simone-piccinini/Hybrid-Reaction-Wheel-Pendulum/docs/architecture/class_diagram.png

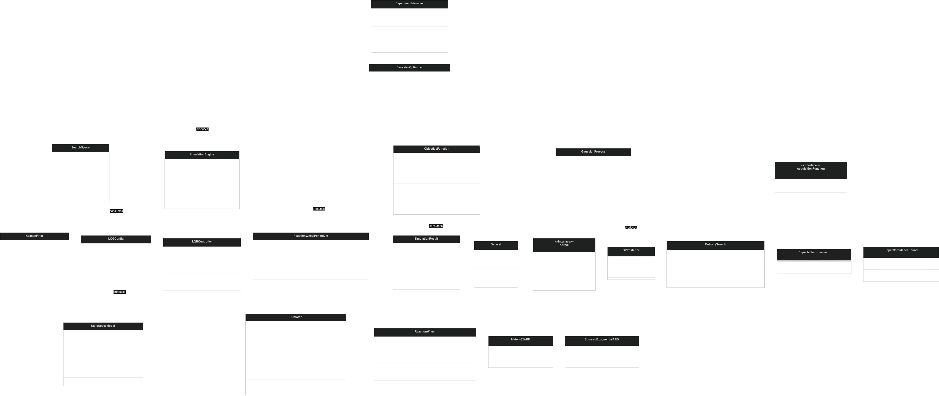
docs/architecture/class_diagram.png
