simone-piccinini/Hybrid-Reaction-Wheel-Pendulum/build/first_build/all2.jpeg

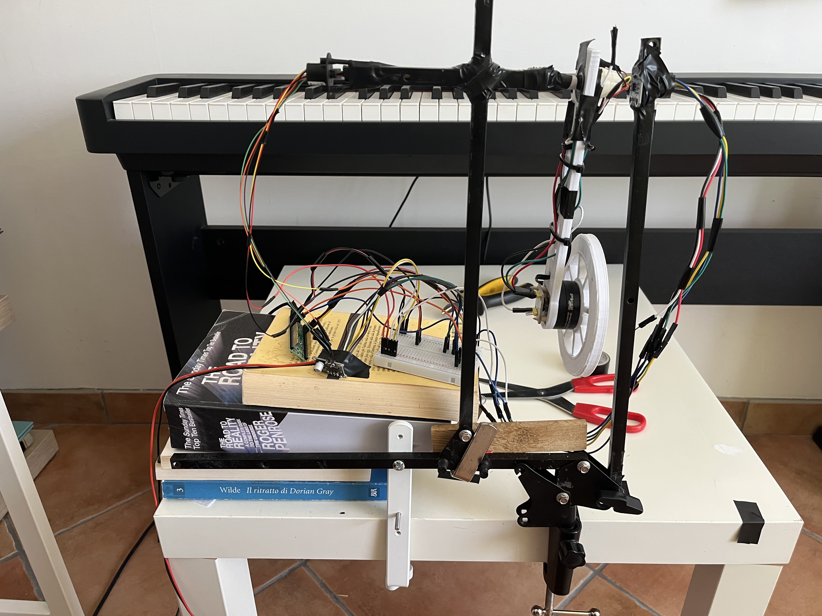
build/first_build/all2.jpeg
