simone-piccinini/Hybrid-Reaction-Wheel-Pendulum/build/first_build/connections.jpeg

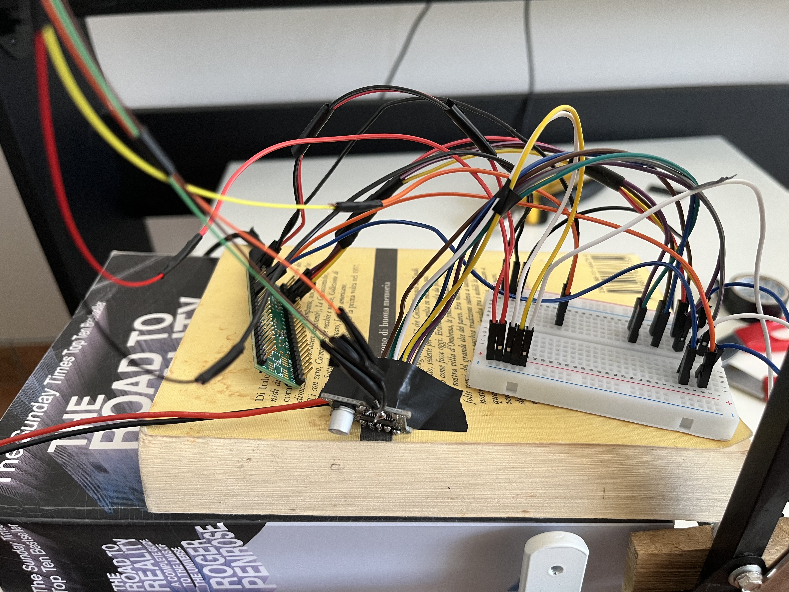
build/first_build/connections.jpeg
