simone-piccinini/Hybrid-Reaction-Wheel-Pendulum/build/first_build/sail_ring.jpeg

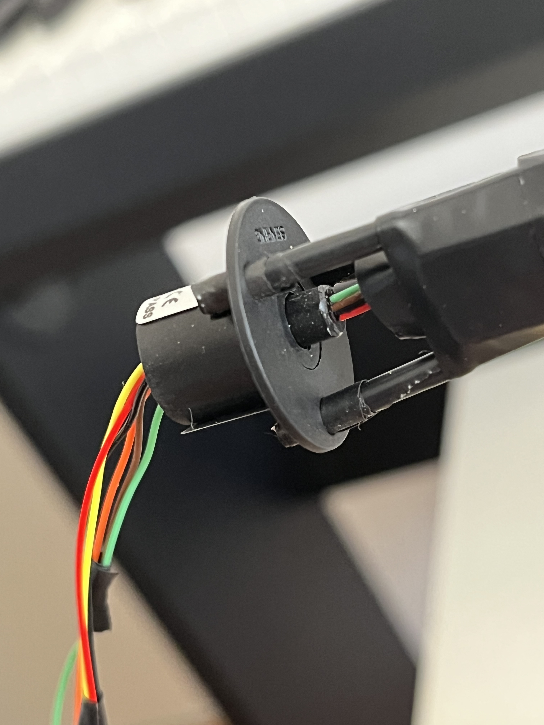
build/first_build/sail_ring.jpeg
