simone-piccinini/Hybrid-Reaction-Wheel-Pendulum/results/build_v2/convergence.png

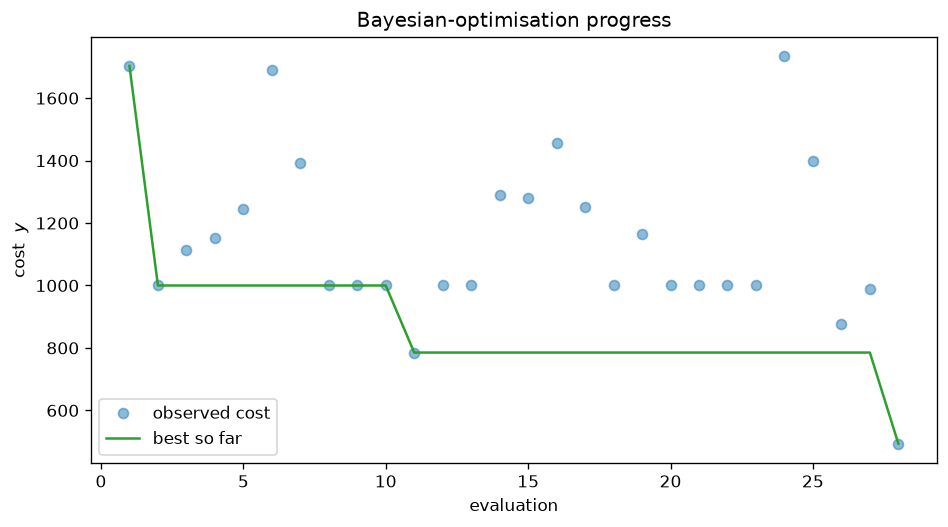
results/build_v2/convergence.png
