simone-piccinini/Hybrid-Reaction-Wheel-Pendulum/results/build_v2/trajectory.png

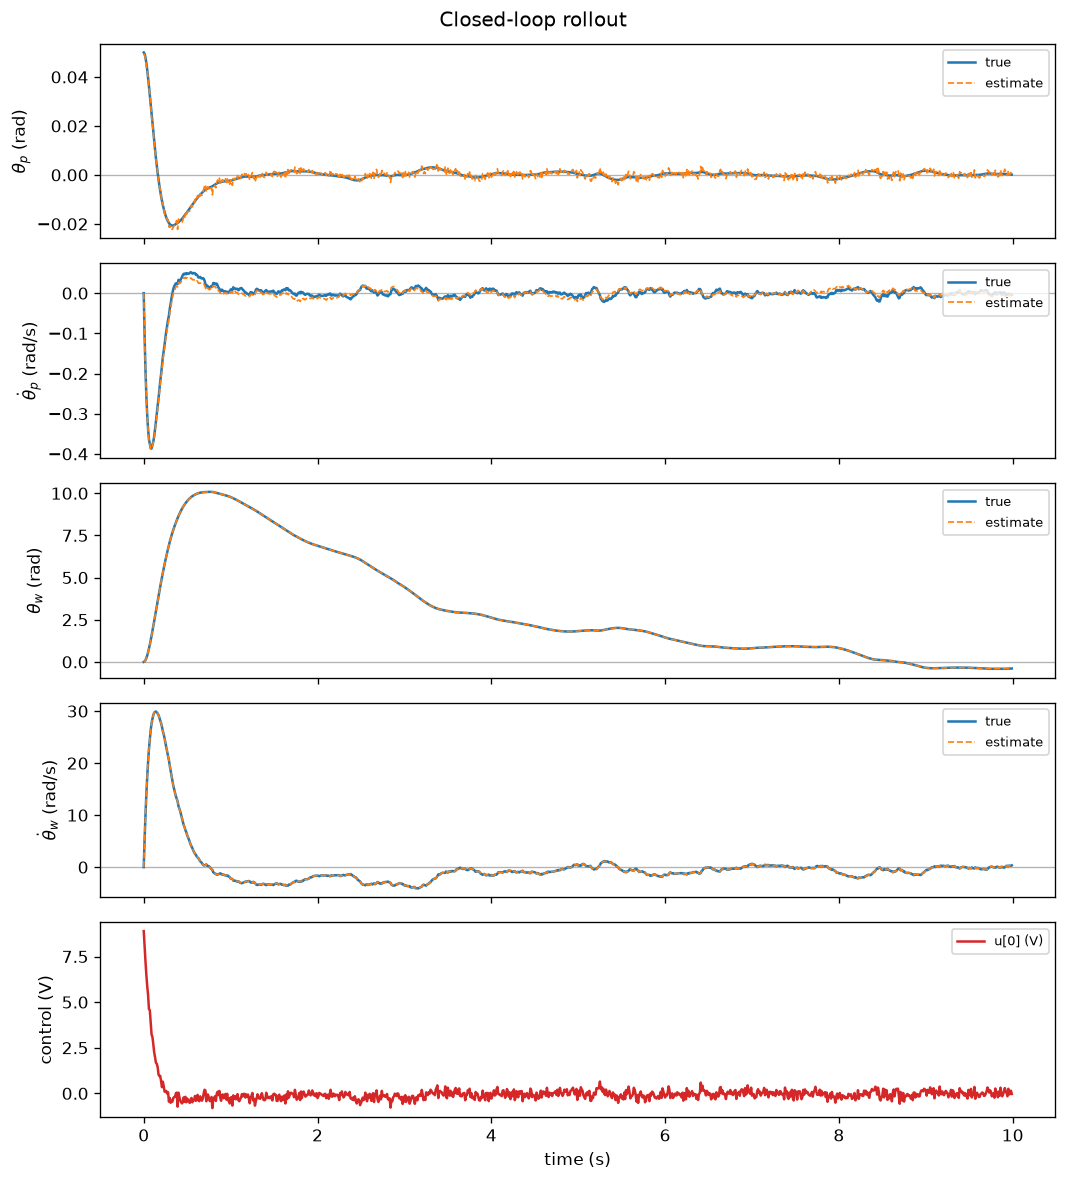
results/build_v2/trajectory.png
