simone-piccinini/Hybrid-Reaction-Wheel-Pendulum/results/build_v2_fw/convergence.png

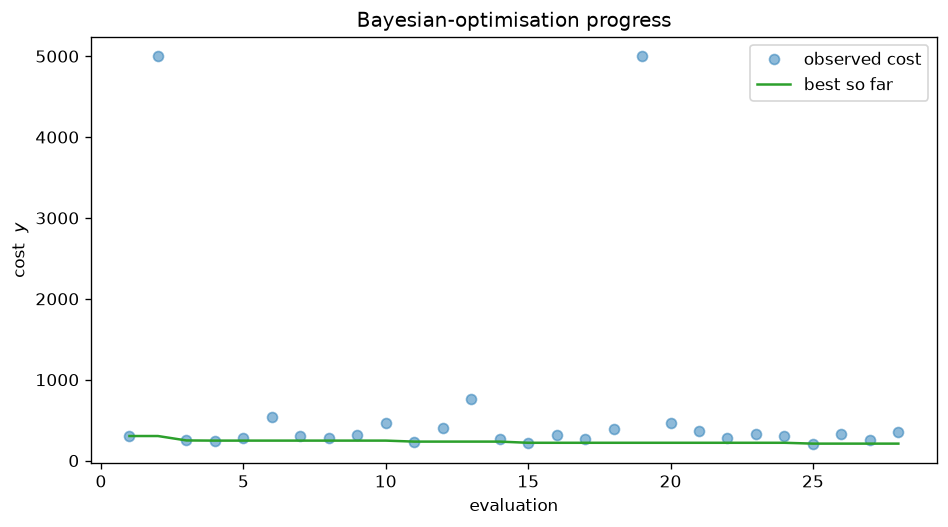
results/build_v2_fw/convergence.png
