simone-piccinini/Hybrid-Reaction-Wheel-Pendulum/results/build_v2_fw/trajectory.png

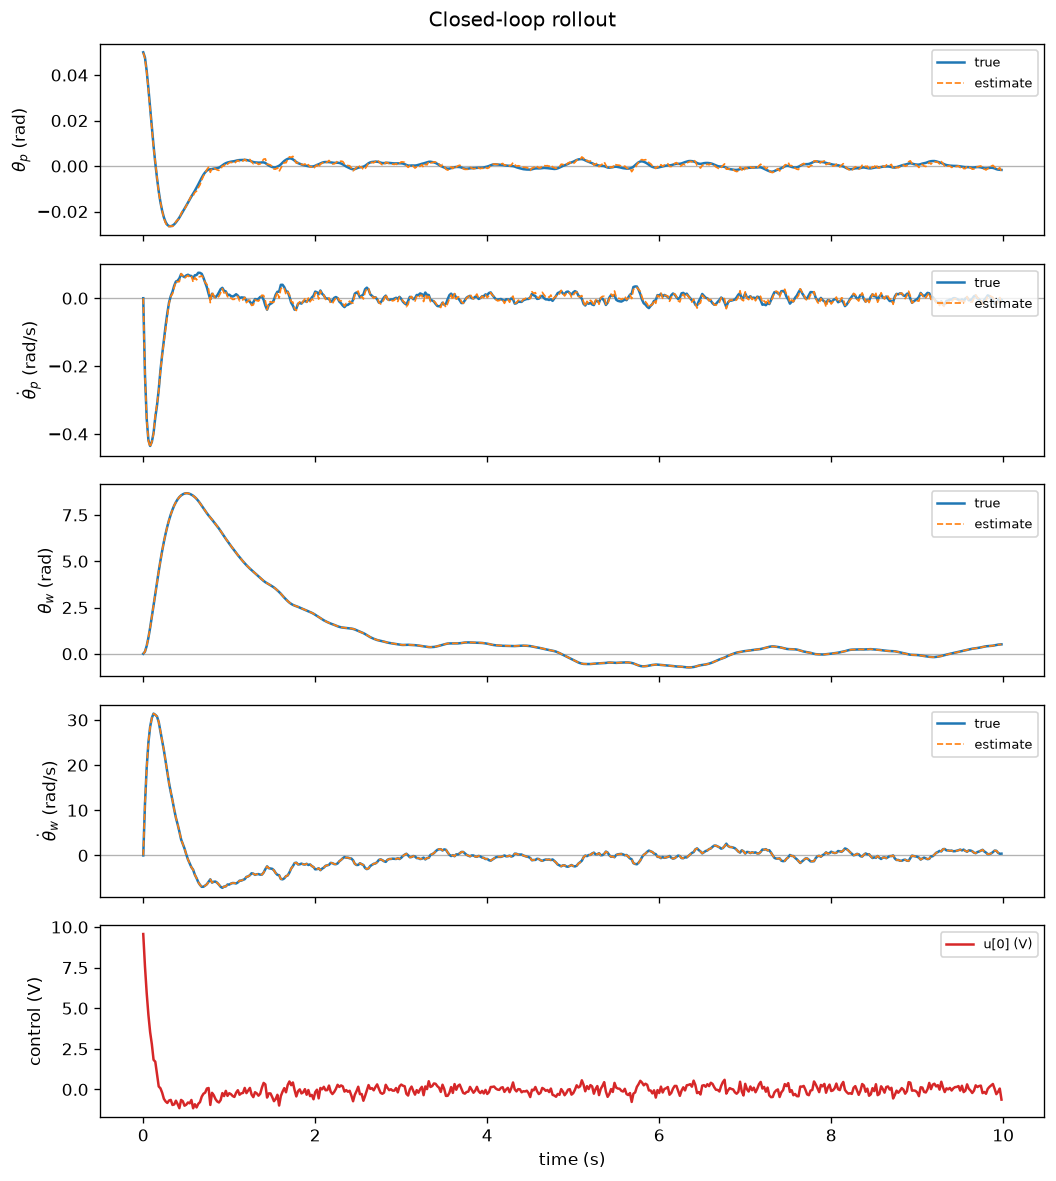
results/build_v2_fw/trajectory.png
