simone-piccinini/Hybrid-Reaction-Wheel-Pendulum/results/build_v2_measured/convergence.png

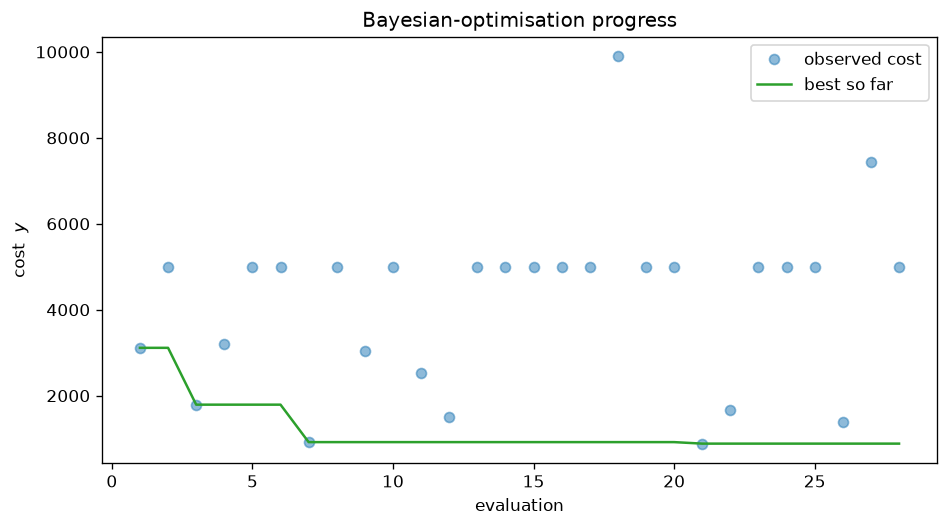
results/build_v2_measured/convergence.png
