simone-piccinini/Hybrid-Reaction-Wheel-Pendulum/results/build_v2_measured/trajectory.png

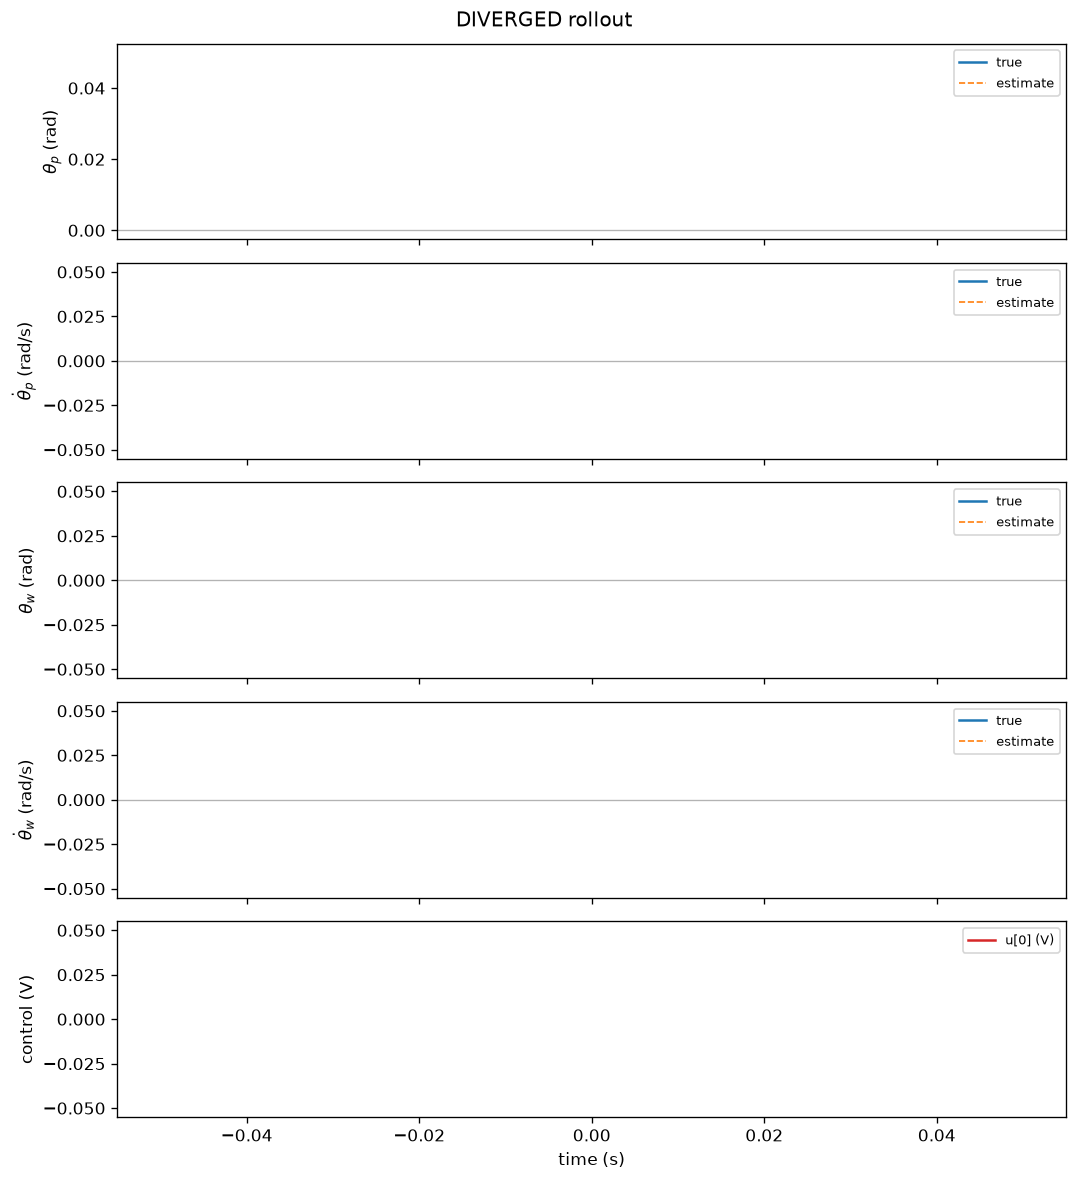
results/build_v2_measured/trajectory.png
