simone-piccinini/Hybrid-Reaction-Wheel-Pendulum/results/AT1/convergence.png

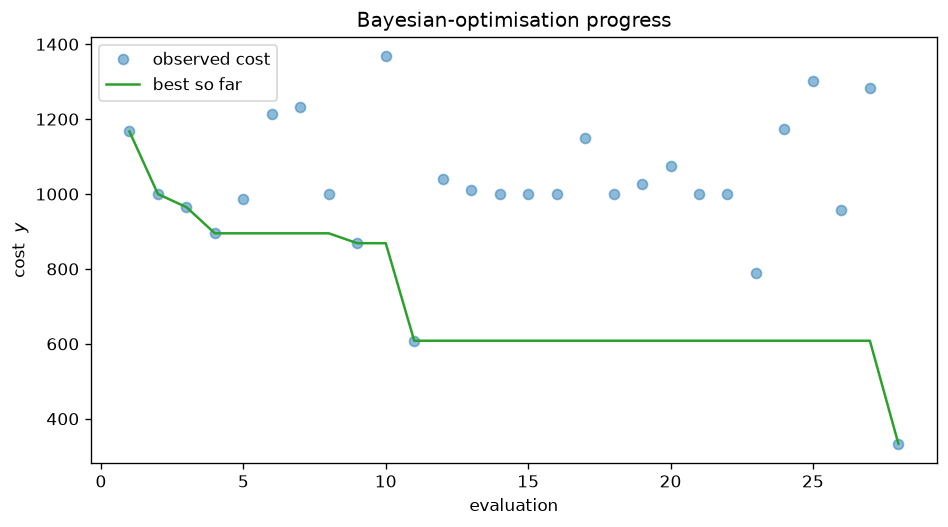
results/AT1/convergence.png
