simone-piccinini/Hybrid-Reaction-Wheel-Pendulum/results/AT1/trajectory.png

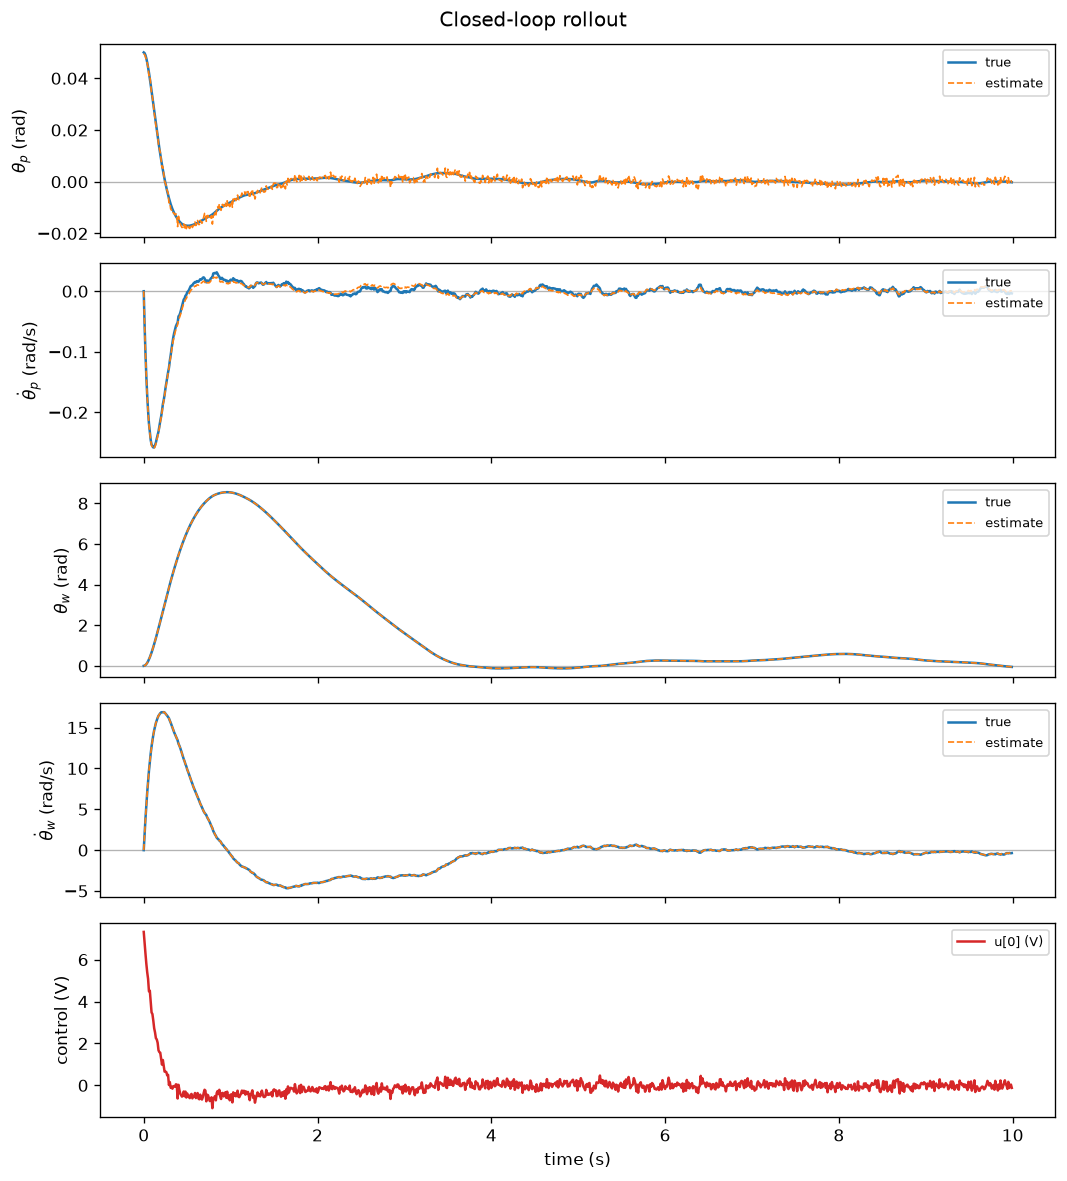
results/AT1/trajectory.png
