simone-piccinini/Hybrid-Reaction-Wheel-Pendulum/results/identified/convergence.png

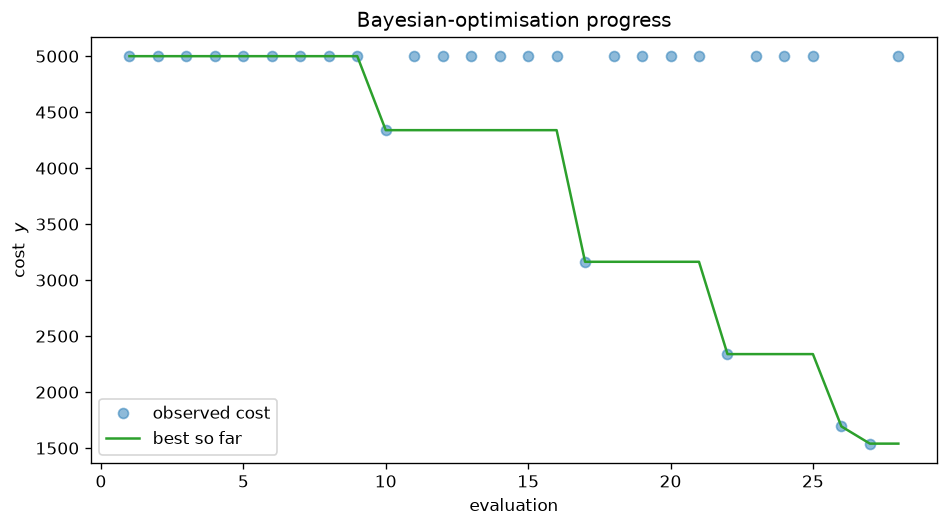
results/identified/convergence.png
