simone-piccinini/Hybrid-Reaction-Wheel-Pendulum/results/identified/trajectory.png

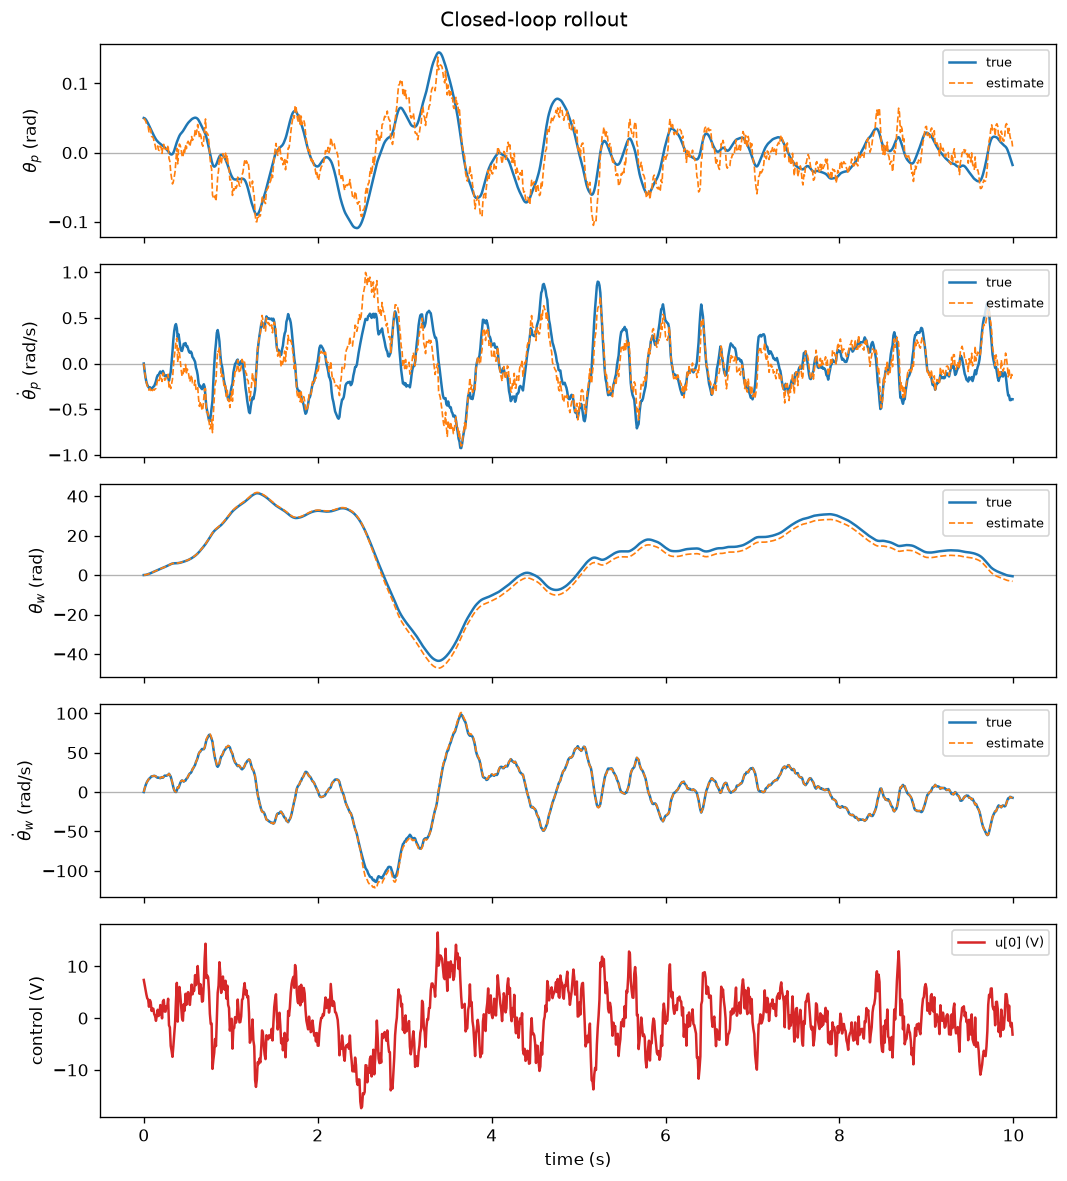
results/identified/trajectory.png
