simone-piccinini/Hybrid-Reaction-Wheel-Pendulum/results/identified_swingup/swing_up.png

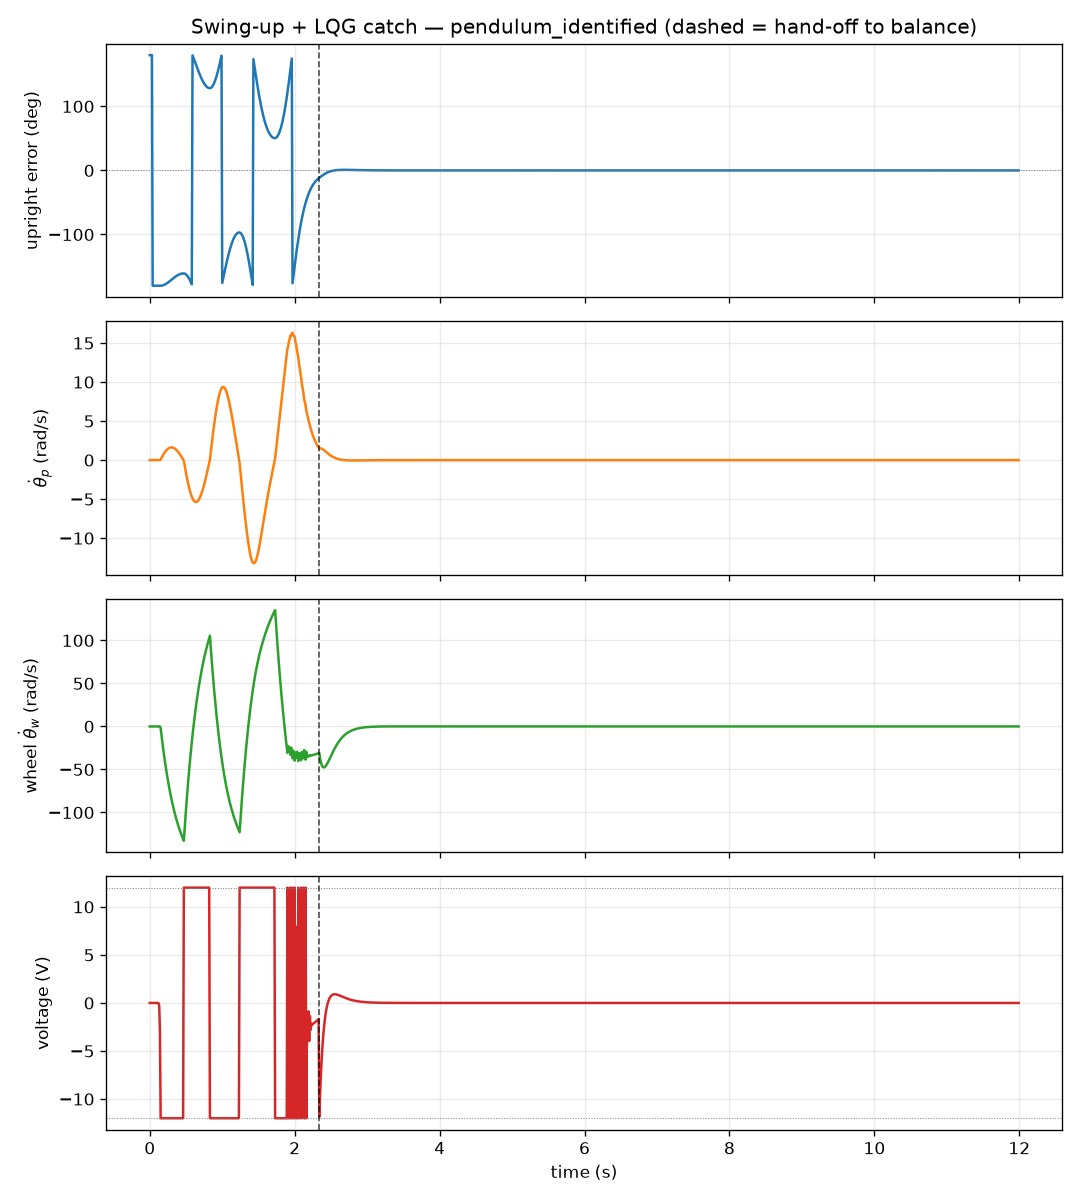
results/identified_swingup/swing_up.png
