simone-piccinini/Hybrid-Reaction-Wheel-Pendulum/results/margins/loop_bode.png

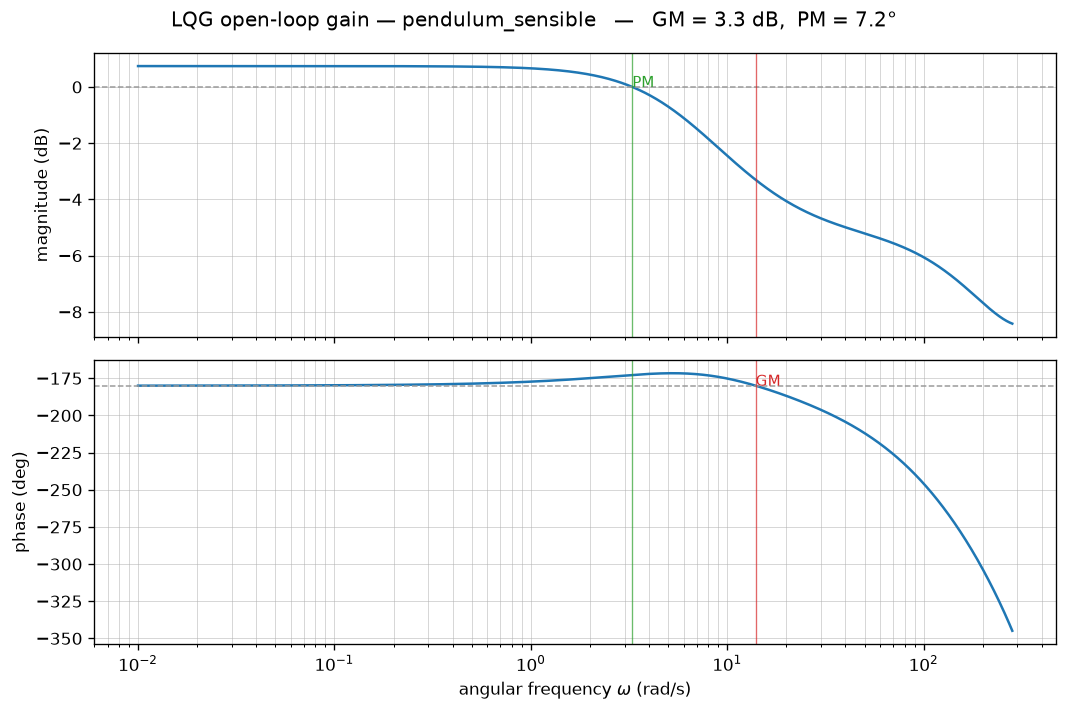
results/margins/loop_bode.png
