simone-piccinini/Hybrid-Reaction-Wheel-Pendulum/results/run01/convergence.png

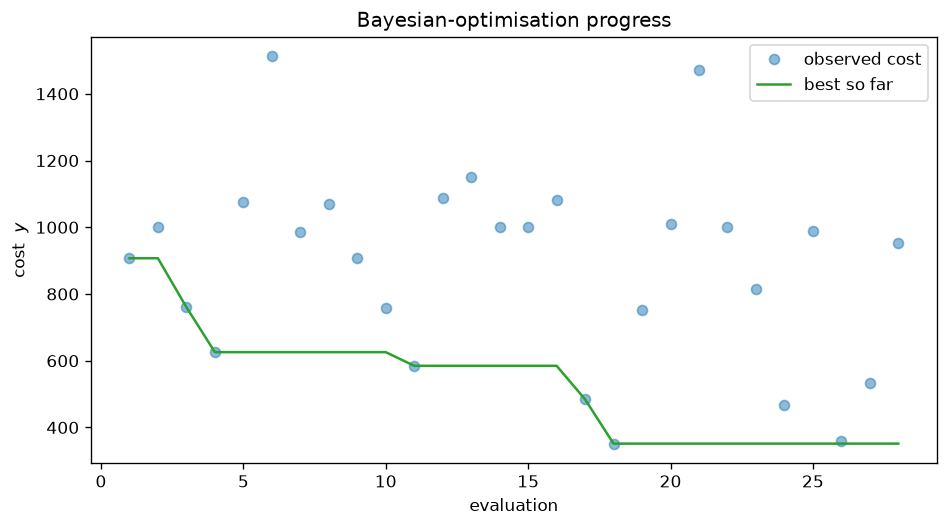
results/run01/convergence.png
