simone-piccinini/Hybrid-Reaction-Wheel-Pendulum/results/run01/trajectory.png

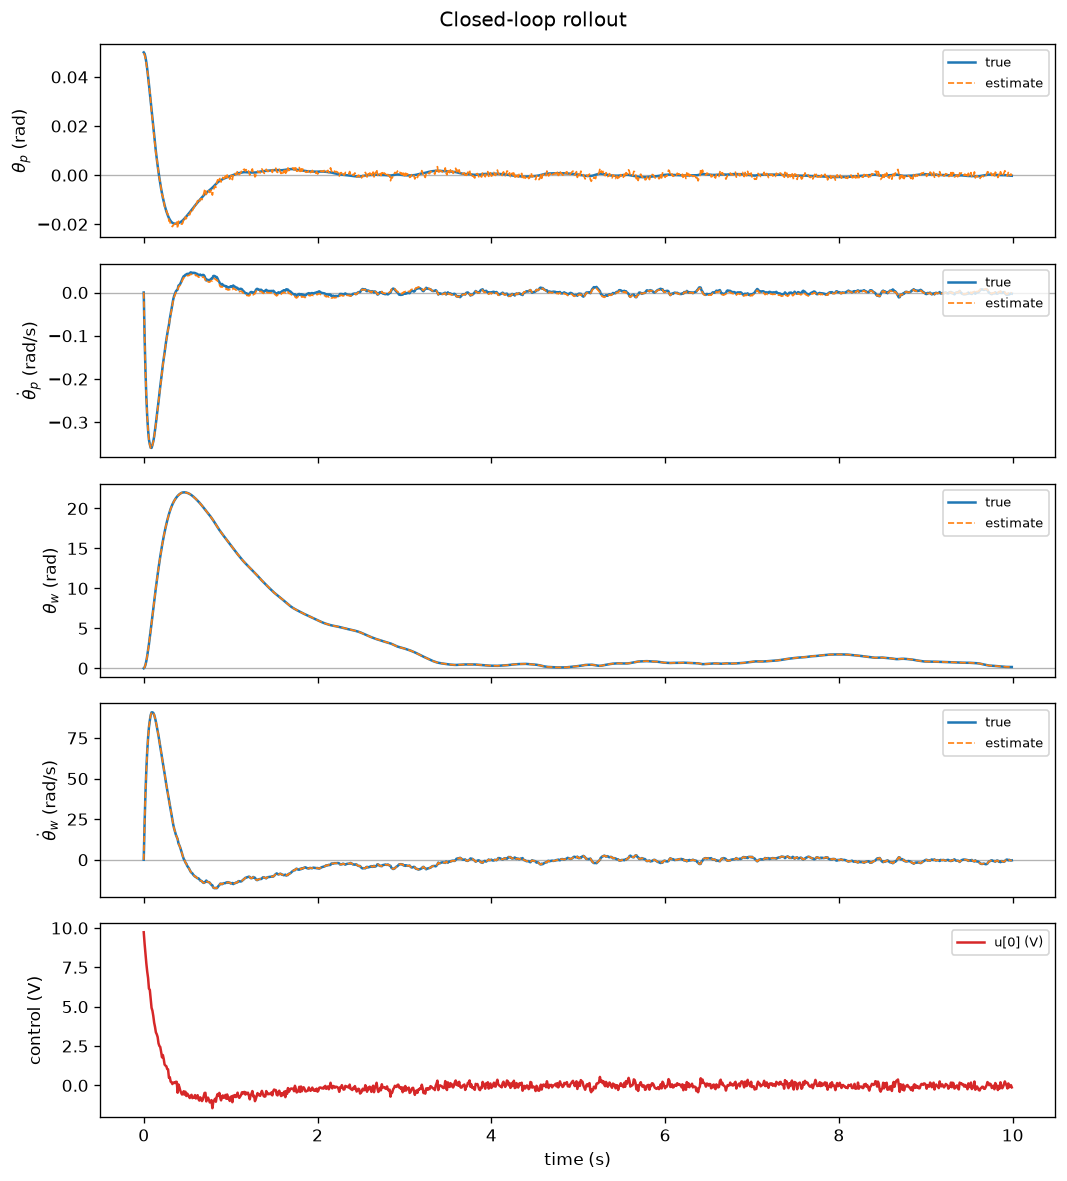
results/run01/trajectory.png
