simone-piccinini/Hybrid-Reaction-Wheel-Pendulum/results/swingup/swing_up.png

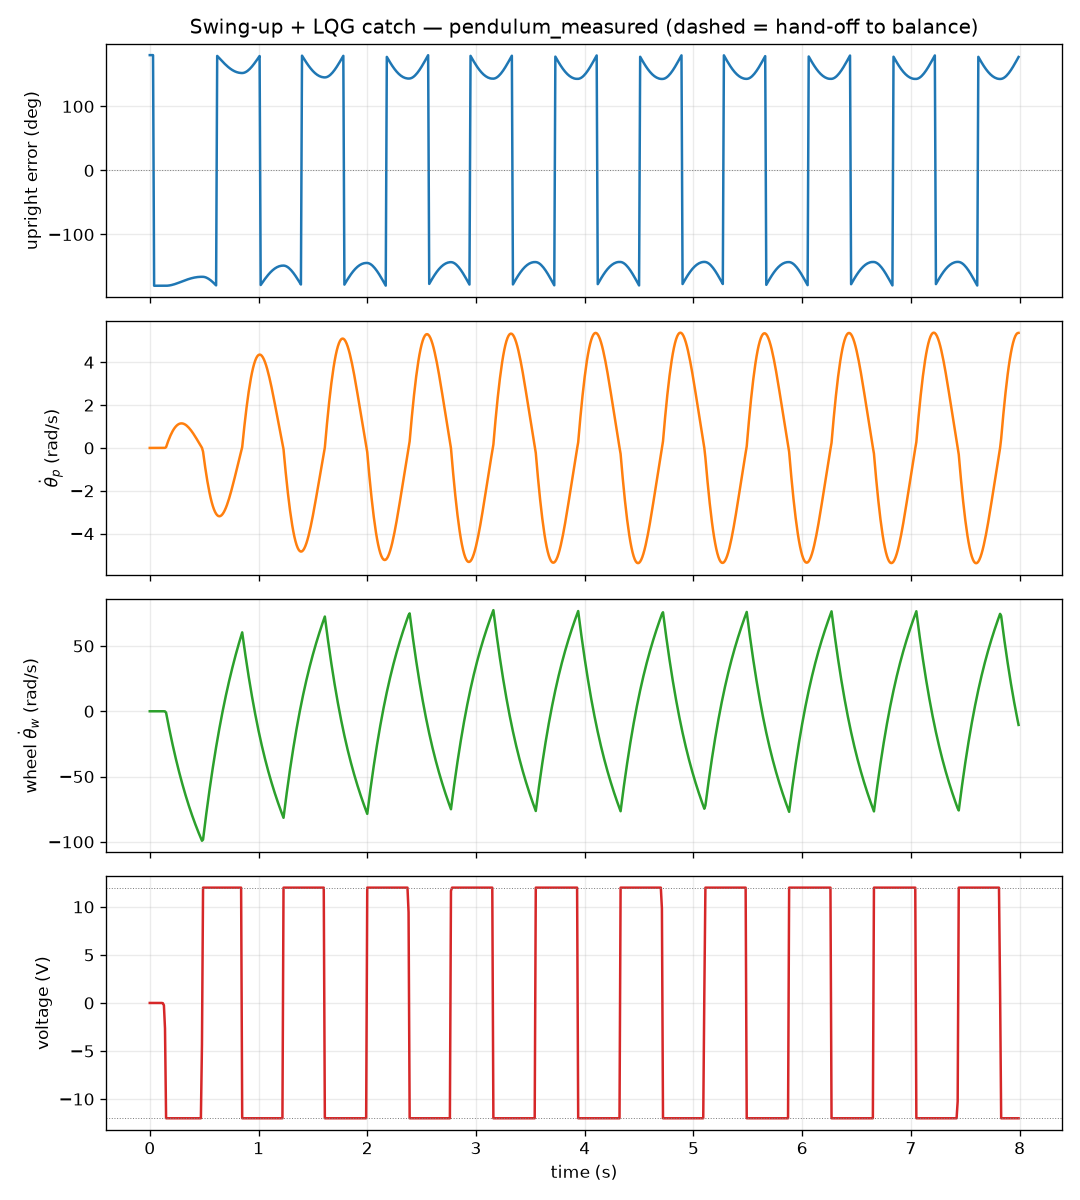
results/swingup/swing_up.png
