simone-piccinini/Hybrid-Reaction-Wheel-Pendulum/results/swingup_feasible/swing_up.png

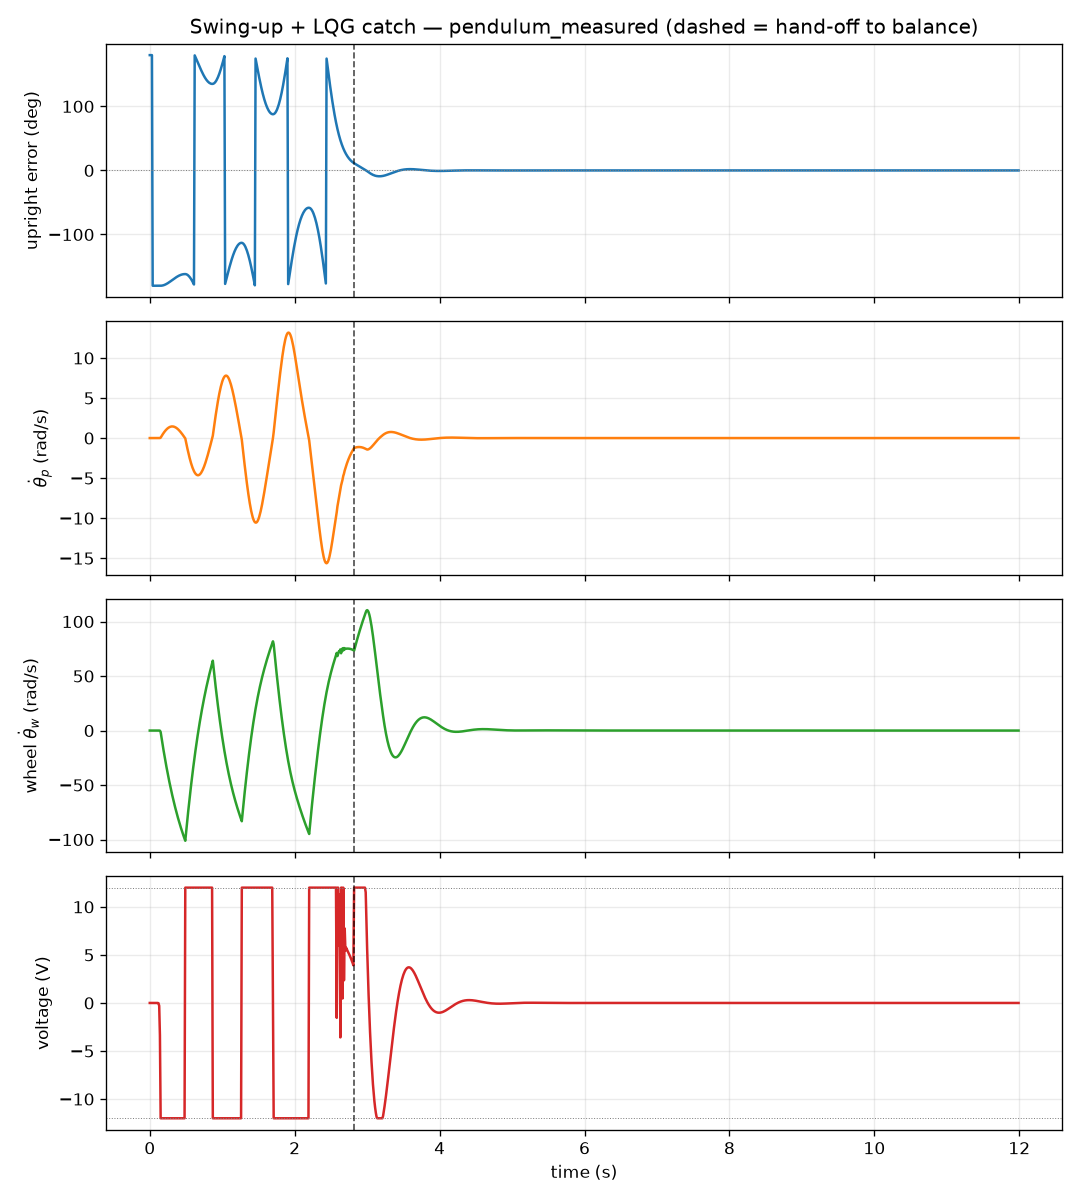
results/swingup_feasible/swing_up.png
