simone-piccinini/Hybrid-Reaction-Wheel-Pendulum/(commit log)

2026-05-31 feat(numerics): complete the layer (matrix_exp, integrators, DARE, optimizers)
    matrix_exp: scaling-and-squaring + Padé-13. integrators: rk4, euler. riccati: discrete DARE via value iteration (lqr.md), with the Kalman dual; replaces the earlier continuous CARE per the discrete-time control design. optimizers: BFGS + Armijo line search + seeded multi-restart for ML-II. constants: added §5 ML-II tolerances.
    Pure numpy (@ only); reference cross-checks (scipy/numpy.linalg) in tests/validation. Full suite: 75 passed. Not pushed.
2026-05-31 feat(core): LQGConfig — vec(Q,R,W,V) packing in log-space
    Diagonal weight matrices (positive diagonal), to_vector/from_vector round-trip via log/exp, tolerance-based equality. d = 2*n_x + n_u + n_y = 11 for the project dims.
2026-05-31 feat(core): SearchSpace — BO box with Latin-hypercube sampling
    Operates in GP search coordinates (log-space where log_scale); sample (LHS, seeded), clip, contains, to_natural. Validated bounds.
2026-05-31 feat(core): Dataset and GPPosterior
    Dataset: mutable BO history with read-only X/y views, rejects non-finite targets (§7). GPPosterior: frozen, enforces non-negative variance — clips round-off, raises below -ATOL (§4).
2026-05-31 feat(core): SimulationResult — completes the core value objects
    Frozen rollout output; cross-validates trajectory shapes (T, n_x/n_u/n_y) against the carried LQGConfig; read-only arrays; type-checked seed/diverged/config.
2026-06-12 feat(physical): DCMotor — steady-state voltage→torque actuator model
    Inductance-neglected DC motor consistent with the 4-state plant of
    docs/theory/model.md: i = (V − K_e·ω)/R_a, τ = K_t·i, with voltage and
    current saturation. Exposes the lumped scalars E = K_t/R_a
    (voltage_to_torque_gain) and K_t·K_e/R_a (back_emf_damping) that model.md
    folds into E and D. numpy/stdlib only; 17 unit tests.
2026-06-12 feat(physical): ReactionWheel — flywheel with viscous bearing friction
    Net wheel torque after friction (model.md b_w, lumped into D) and stored
    angular momentum L = I_w·ω. Validates I_w > 0 (a model.md denominator) and
    the rigid-body bound I_w <= m·r². Stdlib only; 17 unit tests.
2026-06-12 feat(physical): ReactionWheelPendulum — nonlinear plant + upright linearisation
    Composes DCMotor and ReactionWheel into the 4-state plant of model.md.
    nonlinear_dynamics(state, torque) implements the sin-theta equations of
    motion whose theta=0 linearisation is exactly model.md's explicit A, B;
    state_derivative(state, voltage) composes through the motor's saturated
    voltage-to-torque map. linearize() assembles A, B verbatim with the lumped
    E and D scalars, C selecting [theta_p, theta_w_dot] (n_y=2), and is
    cross-checked in unit tests by a central finite-difference Jacobian of the
    nonlinear dynamics at the origin.
    Validation tests confirm model.md's cautions: open-loop A unstable, the
    [theta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
2026-06-12 feat(dynamics): NonlinearPlantModel — ZOH stepper for the true plant
    One zero-order-hold step x_{k+1} = step(x_k, u_k) of the full sin-theta
    dynamics via the numerics rk4/euler integrators, voltage held constant
    across the step (the usage integrators.py prescribes). This is the
    ground-truth propagator the simulator will use for true_states; it shares
    the step(state, voltage) protocol with the upcoming LinearizedPlantModel
    so the two are interchangeable. 11 unit tests, including a hand-rolled
    RK4 cross-check and an rk4-vs-euler accuracy ordering test.
2026-06-12 feat(dynamics): LinearizedPlantModel — completes the dynamics layer
    The model.md step 5-6 pipeline: pair the continuous upright linearisation
    with its ZOH discretisation at the control sampling period, handing off
    (A_d, B_d, C) to control/estimation. Construction enforces that the pair
    shares dimensions and the output map (C, D). Exposes the same
    step(state, voltage) protocol as NonlinearPlantModel (exact ZOH update
    x+ = A_d x + B_d u), so the simulation layer can swap true plant and
    linear approximation; a unit test pins the small-angle agreement of the
    two steppers and their divergence at large angle.
    Validation: rk4 trajectory of the composed plant matches a 1e-12-tolerance
    scipy solve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
2026-06-12 feat(control): LQRController — DARE-designed gain + u = -K x_hat
    The control layer per docs/theory/lqr.md: from_model solves the DARE on
    the discrete (A_d, B_d) via numerics solve_dare, reads off K, and enforces
    the closed-loop caution with the new shifted-QR spectral_radius — a pole
    within ATOL of the unit circle raises UnstableClosedLoopError (the
    configuration error the optimizer will map to a finite penalty).
    from_config consumes the LQGConfig boundary object (W/V ignored, they
    belong to the estimator). compute_control applies u = -K x_hat.
    Tests pin the DARE fixed-point residual, the gain formula, and the lqr.md
    caution (zero wheel-angle weight leaves the wheel integrator ON the un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
2026-06-12 feat(estimation): KalmanFilter — predict/update recursion + dual-DARE steady state
    The LQG estimator: standard discrete predict/update (Joseph-form
    covariance, gain applied as an SPD chol_solve, never an explicit inverse)
    on the discretised plant, with W_process/V_measure named per notation
    section 5. steady_state_kalman_gain reuses the one Riccati routine via the
    duality substitution A->A', B->C', Q->W, R->V — one solver, called twice.
    Documented physics: the locked sensor set [theta_p, theta_w_dot] leaves
    the wheel angle unobservable at a unit-circle eigenvalue, so no
    steady-state filter exists for it — the dual DARE correctly refuses
    (RiccatiNotConverged, pinned by a test) and the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
2026-06-12 feat(simulation): SimulationEngine + Disturbances — the BO loop's oracle
    run(config, seed) plays the full closed-loop LQG cycle on the true
    nonlinear plant: measure (C x + v), condition the Kalman filter, apply
    u = -K x_hat, advance the sin-theta dynamics under ZOH plus process
    noise. Produces the typed SimulationResult with the seed recorded; a
    rollout is byte-reproducible from (config, seed) per the determinism
    contract, so the diagram's step()/reset() are folded into the atomic run.
    Disturbances carries the TRUE world noise (per-channel std, seeded
    Generator draws), deliberately distinct from the config's W/V — those are
    what the filter assumes and what the optimiser tunes; taking th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
2026-06-12 feat(optimization): ARD kernels — base interface, SE and Matern-5/2
    The data_contracts section 7 Kernel ABC: ARD lengthscales + signal
    variance, covariance/matrix/gradient, hyperparams flat vector with a
    functional with_hyperparams update for ML-II. matrix() is the textbook
    double loop over covariance() — Gram matrices here are tens-by-tens and
    clarity wins. SquaredExponentialARD implements R&W eq. 5.1, Matern52ARD
    eq. 4.17 with the hand-derived dk/dr = -(5r/3)(1+sqrt5 r) sigma_f^2
    e^{-sqrt5 r} (smooth at r=0). Analytic gradients are pinned against
    central finite differences for both kernels — the ML-II prerequisite.
    21 unit tests.
2026-06-13 feat(optimization): GaussianProcess surrogate + ML-II inner loop
    GaussianProcess implements R&W Algorithm 2.1 verbatim on the project's
    own Cholesky (predict eqs. 2.25/2.26, log marginal likelihood eq. 2.30),
    standardising targets per optimization.md section 6 and storing the
    transform so predictions map back. Conditioning follows numerical_standards
    section 4: always factor K + (sigma_n^2 + PSD_JITTER) I, escalate jitter
    x10 to JITTER_MAX with a warning, then raise. Exposes the joint posterior
    and seeded function sampling that Entropy Search needs (data_contracts
    section 8).
    marginal_likelihood is the section 3 inner loop: maximise eq. 5.8 by
    gradient ascent in log-space from multiple seed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
2026-06-13 feat(optimization): acquisitions — EI, UCB baselines + Entropy Search
    AcquisitionFunction ABC realises the section 4.5 maximisation once (draw a
    candidate set from the SearchSpace, score, take the best); subclasses only
    supply per-candidate scores, all in minimisation convention. EI is the
    Jones et al. closed form adapted to minimisation (clipped >= 0 so it
    doubles as a sampling density); UpperConfidenceBound is GP-LCB for
    minimisation, scoring beta*sigma - mu. Normal pdf/cdf use stdlib math.erf,
    no scipy.
    EntropySearch is the project goal, the Monte-Carlo route of section 4.3:
    representer points drawn from the EI proposal density; p_min estimated as
    the argmin-fraction of joint GP functi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
2026-06-13 refactor(simulation): design failures become a diverged result, not an exception
    A config that cannot yield a stabilising gain (UnstableClosedLoopError) or
    whose Riccati sweep does not converge (RiccatiNotConverged) is now caught
    in SimulationEngine.run and returned as a one-sample diverged=True result
    instead of propagating. This keeps the optimisation layer a pure black-box
    consumer reached only through engine.run -> objective.evaluate
    (dependency_rules section 4): it no longer needs to import or catch the
    control/estimation exception types. The objective maps the diverged result
    to its finite penalty exactly as before.
2026-06-13 feat(optimization): BayesianOptimizer — the outer loop, completing the layer
    The optimization.md section 5 procedure tuning theta = vec(Q,R,W,V) over
    the realised closed-loop cost. Honours the optimiser-isolation rule
    (dependency_rules section 4): reaches the plant only through
    engine.run(config) -> objective.evaluate(result), never importing or
    configuring a controller/filter. Latin-hypercube initial design, then
    acquisition-driven steps each appending one observation and refitting the
    GP hyperparameters by ML-II; the reported answer is the posterior-mean
    minimiser (argmin mu_T), not the best observed point, since under noise the
    lowest observation may be a lucky draw. Search coordinates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
2026-06-13 fix(optimization): guard ML-II against non-finite value/gradient at extreme phi
    The BFGS line search can probe extreme log-hyperparameters where exp or the
    squared signal/noise terms over- or underflow, and where the kernel's cubic
    gradient terms overflow. Such a phi is now treated as infeasible: the
    objective returns a large finite stand-in with a zero gradient (numerical
    standards section 7), and the overflow warnings are silenced. Keeps the
    restart search from crashing or chasing inf without changing any feasible
    evaluation.
2026-06-13 feat(experiment): io layer + ExperimentManager — config-driven reproducible runs
    io/ (cross-cutting leaf, imports core only):
    - config_loader.py — YAML to a typed, validated ExperimentConfig of plain
    data; no domain objects, so the io->core-only rule holds. The schema is
    documented field-by-field in configs/default.yaml.
    - run_logging.py — current_git_hash plus save_run, writing the AGENTS §7
    record: metadata.json (git hash, seed, config, metrics, timestamp),
    trajectories.npz, history.npz. Named run_logging to avoid shadowing the
    stdlib logging module.
    - plotting.py — lazy-matplotlib trajectory and convergence figures.
    experiment/manager.py — ExperimentManager turns an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
    [default.yaml]
2026-06-13 docs: experiment guide, runnable entry point, and a complete-system README
    - docs/guides/running_experiments.md: exhaustive guide to the experiment/io
    layers — the config→run→outputs workflow, the log-space decision vector,
    true-vs-assumed noise, the reproducibility bundle, acquisition choice, and
    extension points.
    - scripts/run_experiment.py: CLI entry point that loads a config, runs the
    tuning loop, prints a summary, and writes the run record.
    - README rewritten to describe the now-complete LQG + Bayesian-optimisation
    system: the no-library ethos, the layered architecture, how to run an
    experiment, and how to test.
    [run_experiment.py]
2026-06-13 docs: codebase documentation set + acquisition-comparison experiment
    A documentation index (docs/README.md) and five topic guides:
    - codebase_overview.md — the guided tour: layers, data flow, conventions,
    and a where-to-look table.
    - numerics_from_scratch.md — every hand-written primitive (linalg, expm,
    integrators, Riccati, eigensolver, BFGS) and the validation cross-checks.
    - control_and_estimation.md — the LQR law and Kalman filter as implemented,
    and the discrete-Riccati duality they share.
    - bayesian_optimization_walkthrough.md — a reading guide to the optimization
    layer following one outer-loop step.
    - experiments.md — an empirical comparison of Expected Improvement,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
2026-06-13 feat(dynamics): frequency response and Bode diagrams from the state-space form
    State space -> Laplace -> frequency: transfer_function evaluates
    G(s) = C(sI-A)^-1 B + D at s = jω (continuous) or z = e^{jωΔt} (discrete),
    and bode() reduces a channel to magnitude (dB) and unwrapped phase (deg).
    The complex solve (sI-A)X = B is done on the project's real from-scratch LU
    via the standard 2n real embedding, so no numpy.linalg/scipy enters src/.
    io.plotting.plot_bode draws the two-row diagram; scripts/frequency_analysis.py
    renders one Bode per channel for a configured plant.
    On the pendulum the diagram restates the eigen-analysis: a peak near the
    unstable pendulum mode (~4 rad/s) and a wheel-an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
    [frequency_analysis.py]
2026-06-13 feat(dynamics): time-domain response — step, transient, and modal analysis
    The time-domain companion to the Bode pipeline, on the project's own numerics
    (expm, eigvals — no scipy in src):
    - free_response: the initial-condition response x(t)=e^{At}x0, propagated
    exactly via expm (the regulation transient for the closed loop).
    - step_response: the unit-step response of any model via ZOH iteration.
    - transient_metrics: rise/peak/overshoot/settling/steady-state (Ogata §5-4).
    - modal_analysis: poles recast as natural frequency and damping ratio.
    - closed_loop(model, K): forms A_cl = A − BK (takes a raw gain, so dynamics
    stays independent of control).
    io.plotting gains plot_time_respons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
    [step_response.py]
2026-06-13 chore: add requirements files and installation/usage notes
    requirements.txt pins the runtime deps (numpy, pyyaml, matplotlib — NumPy as
    a calculator only, per AGENTS §3); requirements-dev.txt adds the reference
    libraries (scipy, scikit-learn, filterpy) that only tests/validation/ import.
    README gains an Installation section and the fast analysis-script commands
    (Bode, step response, acquisition comparison). Run artifacts stay gitignored
    under results/.
2026-06-13 feat(scripts): one timestamped folder per experiment run
    run_experiment.py now defaults its output to results/<name>/<timestamp>/ so
    successive runs of the same config are preserved side by side instead of
    overwriting; an explicit -o still selects a fixed directory. The running-
    experiments guide documents the per-run layout and explains how to read the
    .npz / .json outputs and why those formats (JSON for small metadata, .npz for
    the lossless named float64 time-series arrays).
    [run_experiment.py]
2026-06-14 feat(optimization): redesign the objective — ITAE + control energy + hinge specs
    Replace the symmetric quadratic Mp/Ts cost with a performance-oriented one
    (notation.md §6):
    y = w_error·ITAE + w_control·∫u²dt
    + w_overshoot·max(0,(Mp-Mp_desired)/Mp_max)²
    + w_settling ·max(0,(Ts-Ts_desired)/Ts_max)²
    [ + w_saturation·max(0, max|u| - U_max)² ]
    - ITAE = ∫ t·|e(t)| dt (new metrics.performance_metrics.itae, trapezoidal)
    judges the whole error history and, via the time weight, rewards fast
    settling and zero steady-state error.
    - ∫u²dt limits control energy; an optional hinge on max|u| past U_max guards
    the actuator.
    - The Mp/Ts penalties are ASYMMETRIC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
    [default.yaml]
2026-06-14 feat(scripts): sensible-pendulum config and two-stage warm-started experiment
    configs/pendulum_sensible.yaml is a realistic bench-scale plant with several
    rollouts averaged per evaluation (n_rollouts_per_eval = 5) and achievable
    objective targets so the hinge penalties are informative rather than always
    saturated.
    scripts/two_stage_experiment.py runs an exploration stage over the full search
    box, then a refinement stage that reuses the first stage's data two ways:
    warm-starting the new GP with every prior evaluation, and focusing the new
    search on a tight log-box around the first stage's best observed point. The two
    winners are re-scored over several seeds for a fair comparison; both runs a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
    [pendulum_sensible.yaml, two_stage_experiment.py]
2026-06-14 feat(dynamics): open-loop LQG loop gain and stability margins (Bode for margins)
    Add the expert's frequency-domain robustness plot: the loop transfer function
    of the broken loop and its phase/gain margins.
    - loop_transfer_function(plant, K, L, omega): the LQG return ratio at the input,
    L(z) = -K_c(z)·G(z), with the controller realised in current-estimator form
    (A_c=(A_d-B_dK)(I-LC), B_c=(A_d-B_dK)L, C_c=-K(I-LC), D_c=-KL). Discrete loop,
    built on the from-scratch complex solve.
    - stability_margins(omega, L): phase margin at the gain crossover and gain
    margin at the -180 deg phase crossover, by interpolation on the grid.
    - io.plotting.plot_loop_bode: the annotated open-loop Bode (0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
    [stability_margins.py]
2026-06-16 docs(hardware): complete bill of materials and wiring guide
    A full parts list to physically build the reaction-wheel pendulum the repo
    simulates: the recommended BLDC + SimpleFOC build (ESP32, SimpleFOCMini,
    gimbal motor, two AS5600 angle sensors, 12 V supply, mechanics), cheaper and
    higher-end alternatives, and a literal brushed-DC variant — all inside a
    €100–150 budget. Includes the mapping from each part to the control model
    (FOC torque mode realises the τ=K_t·i DC-motor model so the tuned gains
    transfer), the ESP32↔SimpleFOCMini↔AS5600 pinout, the two-AS5600 I²C
    address-clash workaround (dual I²C bus), power options, and firmware bring-up
    notes. Linked from the docs index.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
2026-06-16 docs(hardware): sensors, I2C bus, and magnets explainer
    Explains why two AS5600 are needed (pivot -> theta_p, motor -> wheel speed;
    the Kalman filter reconstructs the rest), how the I2C bus works and the
    fixed-address (0x36) clash of two identical AS5600 — with the fixes (separate
    hardware buses: Teensy 4.0 has three, ESP32 two; TCA9548A multiplexer; PWM/
    analog output; or an MPU6050 mix), and what the diametric magnets are for
    (one per sensor, diametric not axial, centred 0.5-3 mm under the chip; sold
    separately). Includes a Teensy/ESP32 bus-and-pin recap. Linked from the docs
    index and cross-referenced from the BOM.
2026-06-16 docs(hardware): the engineering reasoning for sizing the pendulum arm
    Derives how long the arm can be for the GBM2804H-100T: the three limits of a
    reaction-wheel pendulum (torque vs gravity M·g·ℓ·sinθ_c ≤ τ_max, wheel-momentum
    saturation I_w·ω_max, and the √(g/L) fall timescale), the motor's real ceiling
    (K_t≈0.037 N·m/A; peak torque set by the winding V/R≈1.2 A on 12 V, not the
    driver's 2.5 A; ~0.04 N·m peak, ~0.02 N·m design), and a catch-angle × arm-length
    table → ~12–15 cm recommended (up to ~20 cm light/peak). Frames the general
    requirement→load→actuator→margin→iterate→verify method (with drone/robot-arm
    analogues) and closes the loop with the simulato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
2026-06-25 docs(hardware): reaction-wheel design — inertia sizing and mounting
    Explains how to size and model the reaction wheel: the wheel is an
    angular-momentum store, the reaction torque equals the motor torque
    (independent of I_w) while the inertia I_w buys momentum capacity
    H_max = I_w·ω_max; derives the target I_w ≈ 1e-4 kg·m² from the catch-momentum
    requirement; gives the inertia formulas, the "mass at the rim" rule (inertia
    ∝ r² but only linear in mass → light + large radius), recommended dimensions
    (Ø~100 mm, ~40–60 g, rim-loaded), a worked PLA-disk + steel-rim example, the
    trade-offs, the concentric outrunner mounting (stator→arm, wheel→rotating
    bell, magnet→rear shaft),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
2026-06-27 docs: measured-build experiment, robustness analysis, and scripts guide
    - configs/pendulum_measured.yaml: real CAD/measured plant params (0.125 kg
    tip, I_b=0.00281, Onshape wheel, R_a=10 Ω, K_t=K_e=0.037, 12 V rail).
    - docs/papers/robustness_lqg_measured.md: stability-margin study of the
    BO-tuned LQG on the measured plant — gain-robust (6.85 dB, +120%) but
    delay-fragile (PM 11.6°, ~57 ms), with Doyle's caveat and firmware
    implications. Margins computed on the actual tuned (Q,R,W,V).
    - docs/guides/analysis_scripts.md: tour of scripts/, deep-diving
    stability_margins.py and why open-loop margins predict real-hardware
    behaviour a clean rollout hides.
    - docs/README.md: index the n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
    [pendulum_measured.yaml]
2026-07-10 docs: publishing polish — README rewrite, papers index, folder tidy-up
    - README.md: rewritten around the project's key idea — automatic LQG
    hyperparameter tuning by Entropy Search, explicitly framed as a
    from-scratch implementation of Marco et al., ICRA 2016
    (arXiv:1605.01950). Adds the BO<->simulation loop diagram, a
    step-by-step "how a tuning run works", the full repository structure,
    the measured-build results, and a references section.
    - docs/papers/README.md: new papers index — the inspiration paper with a
    table of this repo's adaptations (LQR->LQG, arm->reaction wheel,
    hardware->simulation) and where each reference lives in the code.
    - docs/README.md: link the paper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
2026-08-17 docs(theory): write the real Kalman filter brief
    kalman.md was a byte-identical copy of lqr.md. Replace it with the
    actual estimator derivation — predict/update recursion, Joseph-form
    covariance, the dual-DARE steady state, and this plant's wheel-angle
    detectability caveat — matching estimation/kalman_filter.py (whose
    docstrings already cite kalman.md's Duality note).
2026-08-17 feat(optimization): stability-margin penalty in the tuning objective
    The rollout cost measured only clean-simulation performance (ITAE,
    energy, overshoot/settling), so the Bayesian optimiser was free to
    return delay-fragile LQG controllers — the Doyle-1978 trap the measured
    build fell into (PM 11.6 deg, ~57 ms delay budget). Add an optional,
    asymmetric hinge on the LQG loop's phase and gain margins that fires
    when a margin drops below its threshold, steering the search toward
    controllers with hardware headroom.
    Architecture: a margin is a property of the *design*, not the rollout
    trajectory, and optimization/ may not import control/estimation/dynamics
    (optimiser-isolation, dependency_rule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
    [default.yaml, pendulum_measured.yaml, stability_margins.py]
2026-08-18 feat(control): energy-shaping swing-up + LQG hand-off (nonlinear demo)
    Add the global maneuver the LQG/BO stack does not cover: bring the
    pendulum from hanging up into the small-angle basin, then hand off to
    the balancing LQG. EnergySwingUpController implements energy shaping
    (Astrom-Furuta) — V = k (E - E_up) theta_dot / E, saturated — derived by
    inverting the plant's own EOM so dE/dt drives the pendulum energy to the
    upright level. scripts/swing_up.py runs the full maneuver on the
    nonlinear plant with a switching supervisor and the recursive Kalman +
    LQR balancer, and reports an up-front torque-vs-friction feasibility.
    Finding: on the measured build the *guessed* pivot friction (b_p=0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
    [swing_up.py]
2026-08-18 docs(theory): swing-up brief (energy shaping + LQG hand-off)
    Add docs/theory/swingup.md in the house style (Goal, intuition, the
    energy-shaping derivation dE/dt = -b_p*thetadot^2 - tau_w*thetadot -> the
    law tau_w = k*Etilde*thetadot -> the saturated voltage command, the
    switching hand-off, and the torque-vs-friction feasibility bound with the
    b_p threshold). Wire it into the docs index and back-reference it from
    the controller module docstring.
2026-08-24 docs: sync for the swing-up and margin-penalty features
    Bring the published docs in line with the two merged branches.
    - README: swing-up in the architecture table, repo tree, and run
    commands; test count 539 -> 577; Results rewritten to cover the
    margin-penalty A/B (delay budget 57 -> 108 ms) and the swing-up
    maneuver incl. its honest infeasibility report on the measured
    plant; Astrom & Furuta added to the references.
    - docs/papers/README.md: add Astrom & Furuta and extend the Doyle
    entry now that the margin penalty exists; note the A/B in §7.
    - docs/guides/analysis_scripts.md: cover scripts/swing_up.py, and
    correct §2.4, which still described the margin penalty as a future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
    [pendulum_measured.yaml]
2026-08-26 hw(wheel): as-built v2 wheel — controllable; adding rim wire is the wrong fix
    The printed PLA wheel measures I_w = 61.1725 kg*mm^2 (6.117e-5 kg*m^2) at
    41.0 g — 64% of the sizing doc's 1.1e-4 target, m_tip 101 g.
    - configs/pendulum_build_v2.yaml: the as-built plant (supersedes
    pendulum_measured.yaml for the physical build), robustness term on.
    - docs/hardware/reaction_wheel_design.md §9: the verdict, with the
    momentum-vs-torque crossing analysis and a simulator sweep.
    Finding: the catch angle is limited by motor torque, not wheel momentum.
    Rim mass raises the momentum ceiling but lowers the torque ceiling (more
    tip mass -> more gravity torque); the two cross at 0.3 g of wire at
    ta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
    [pendulum_build_v2.yaml]
2026-08-30 hw(thermal): the duty ceiling, not the wheel, is the binding constraint
    The v6 firmware caps duty at 250 (throttled ~223) because the motor once
    became "too hot to touch" at duty 237. That cannot have been duty 237:
    with correct wiring it dissipates 0.77 W (2 K in 10 s). A GND/VCC fault
    bypasses the PWM and dissipates 14.4 W - 19x - which matches the symptom.
    The budget was calibrated against a wiring fault.
    - docs/hardware/thermal_and_duty_limits.md: the arithmetic, the real
    sustained limits, and what the cap costs.
    Measured on a balancing rollout: peak duty saturates but only 1.1% of the
    time; MEAN power is 0.118 W (~8% of the sustained envelope), 0.008 W once
    settled, 0.3 K winding ri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
    [pendulum_build_v2_firmware.yaml]
2026-08-30 hw: bring-up pipeline, swing-test firmware, and parameter identification
    Everything needed to go from the built machine to measured parameters,
    short of the balancing controller itself (deliberately not built yet).
    - docs/hardware/firmware_v6_handoff.md + firmware/closed_loop_v6_dualsensor.ino:
    imported verbatim so the repo is self-contained, with a header flagging
    the two conclusions this repo has since revised (the thermal budget and
    the direct-drive torque table, neither of which applies as written).
    - docs/hardware/bringup_pipeline.md: staged plan, risk increasing at each
    step. Stage 0 sensors only, 1 free swing (motor unpowered), 2 wheel with
    the arm clamped, 3 coupled swing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
    [closed_loop_v6_dualsensor.ino, identify_parameters.py, make_synthetic_logs.py, swing_test_v1.ino]
2026-08-31 hw(fix): stage 0 could not see encoder A at all
    The unarmed logging path passed a hardcoded 0.0 for the wheel channel, and
    readAngleA() refuses to read before the arming sweep calibrates it. Stage 0
    would therefore have reported encoder A's noise as exactly zero - a perfect
    sensor - when A is the ANALOG channel, the noisy one, and the one stage 0
    exists to characterise (slip-ring supply modulation shows up here).
    - log encoder A from the raw ADC against a nominal 4062-count span when
    uncalibrated. Noise-floor use only; commutation still requires the
    machine-driven sweep.
    - add a wheel_deg column to the CSV schema. Both encoders report ANGLES, so
    the angle noise is what gets measured;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
    [identify_parameters.py, make_synthetic_logs.py, swing_test_v1.ino]
2026-08-31 hw: y-wobble test, and the linearity check that should have been in stage 0
    The 4-point linearity check on the real build found the pivot encoder
    reporting 100 deg at a true 180 deg - local gain varying 0.29 to 1.49
    around the circle (5.1x) while a full turn still totals 366 deg. That
    pattern is an off-axis magnet: the AS5600 reads field DIRECTION, and a
    magnet off the rotation axis orbits the chip instead of spinning in
    place, so the distortion cancels over a full turn but not locally.
    It matters because the tuned LQG's measured gain margin is 6.85 dB
    (x2.20), so the loop tolerates sensor gain in [0.45, 2.20]. A local gain
    of 0.29 is outside that - no gains fix it.
    Stage 0 measured noise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
    [analyze_wobble.py, y_wobble_v1.ino]
2026-08-31 hw: record the measured sensor characterisation, and what it costs
    Lab record for Stage 0 on the real machine, plus the re-tune against the
    numbers actually measured rather than guessed.
    Measured:
    - noise floor: pivot 0.05 deg (sub-LSB), wheel 0.19 deg. Both pass, twice.
    - linearity: local gain varies 0.29-1.49 around the circle while a full
    turn still totals 366 deg - an off-axis magnet. 0.29 is outside the
    loop's [0.45, 2.20] gain-margin tolerance.
    - wobble: 39.46 deg -> 9.14 deg after re-centring the magnet (4.3x). The
    error is the PRODUCT of eccentricity and tilt, so centring collapsed
    most of it without touching the y-play.
    Consequences, with measured noise and the V box widen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
    [pendulum_build_v2_measured.yaml]
2026-08-31 hw(wobble): PuTTY support, selectable log rate, parseable output
    Fixes a real bug: handleSerial() only accepted LF as a line terminator.
    PuTTY sends CR on Enter, so under PuTTY the Enter key did nothing and a
    running capture could not be stopped. Now accepts CR, LF or CRLF, and
    handles backspace.
    - log rate is selectable with 'f <hz>' (10..1000, default 200). The USB
    CDC baud rate is ignored by the hardware, so PuTTY's Speed field is
    cosmetic - documented in the header so it is not mistaken for a real
    setting.
    - output restructured for machine reading: every non-data line starts
    with '#', captures are bracketed by #BEGIN/#END, metadata is emitted
    as '# key,value', and accepted com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
    [analyze_wobble.py, y_wobble_v1.ino]
2026-08-31 hw(wobble): correct the PuTTY terminal advice in the header
    Local line editing should be Force ON, not off - it lets you see and
    correct a command before Enter sends it, and Enter still stops a running
    capture. Also notes that you type straight into the window (no input
    box) and that the firmware's '# > <cmd>' echo confirms input is arriving
    even when local echo is off.
    [y_wobble_v1.ino]
2026-08-31 hw: give raw hardware logs a version-controlled home
    results/ is gitignored because everything in it can be regenerated by
    re-running a script. Serial captures cannot: they measure a physical
    machine at a moment in time, and once the magnet shifts or a part is
    replaced they are gone. They are also the evidence behind every measured
    number in sensor_characterisation.md.
    data/hw/ is not ignored. README documents the naming and that a whole
    PuTTY session can go in one file, since the analysers skip '#' lines and
    read the #BEGIN/#END blocks.
2026-08-31 hw: serial_log.py - a capture tool that cannot fail silently
    PuTTY session logging produced no file across several attempts, with no
    error shown. Its failure modes (folder does not exist, settings applied
    to a different saved session, logging started after the data scrolled
    past) are all silent, and each costs a full measurement session to find.
    scripts/serial_log.py replaces it: creates the parent folder, tees the
    stream to screen and file, flushes after EVERY line so the tail survives
    a kill, and reports the line count on exit. Refuses with a clear message
    if the port is already held by another program.
    Pipeline doc points at it, and at data/hw/ for the captures.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
    [serial_log.py]
2026-08-31 hw: record the 180 deg wobble result, with its caveats
    y-tilt at upright is 1.49 deg - inside the second-order band and much
    better than the 9.14 deg at hanging. Two things stop that being a clean
    pass, both recorded rather than glossed:
    - the quiet baseline at 180 is 2.99 deg against 0.18 deg at 0 deg, with
    quarter-means climbing monotonically and a +0.106 deg/s trend. That is
    the arm still settling, not sensor noise, and it inflates what the
    quadrature subtraction removes. Detrended jitter is 0.405 vs 0.497 deg
    quiet vs wobble.
    - a small wobble response can mean a COMPRESSED sensor rather than a good
    one. The 90-180 segment measured local gain 0.29, and a region that
    under-res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
    [swing_test_v1.ino]
2026-08-31 hw: stage 1 measured - I_b validated, b_p 37x smaller, swing-up feasible
    Free swing, motor unpowered, ~25 deg release, 20 s at 200 Hz.
    I_b 0.00224935 vs CAD 0.0022725 -> 1.0% apart
    b_p 0.000268852 vs GUESS 0.01 -> 37x smaller
    period 0.773 s vs 0.777 s predicted -> 0.5% apart, zeta 0.0074
    Two consequences.
    The CAD model is validated. I_b comes from the period alone, so this
    result is immune to every angle-distortion problem in the pivot encoder.
    Swing-up flips from impossible to comfortable. swingup.md needs
    b_p < ~0.0027; the guess put us 3.7x the wrong side of it, the measurement
    puts us 10x the right side. Simulated on the identified plant the arm
    swings up in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
    [pendulum_identified.yaml]
2026-08-31 hw: 'm <deg>' linearity marks, and fix a blocking delay in the coast test
    Two things that would have cost a hardware session.
    1. swing_test_v1 'd' (coast-down) called delay(2500) inside the command
    handler. That blocks the main loop, so writePhases() never runs, the
    field freezes at its last angle and the rotor LOCKS instead of
    spinning up - then 'coasts' from standstill. The log would have been
    useless and the motor would have sat in exactly the stalled condition
    the thermal note warns about. Replaced with a scheduled transition
    handled by loop().
    2. y_wobble_v1 gains 'm <deg>': hold the arm at a known mechanical angle
    and it records the reading averaged over 1 s, as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
    [analyze_wobble.py, swing_test_v1.ino, y_wobble_v1.ino]
2026-08-31 chore: track experiment results, and add the stage 0b linearity capture
    results/ was ignored on the grounds that anything in it can be
    regenerated. That is true of the artifacts but not of their provenance:
    each run record carries the config, seed and git hash that produced it,
    and those records are the evidence behind every number quoted in docs/.
    Keeping them tracked means a figure in a document can always be traced
    back to the run that made it.
    2.6 MB across 21 plots, 16 trajectory/history archives and 8 metadata
    files. Editor directories (.theia, .vscode, .idea) are ignored instead.
    Also adds data/hw/s0b_linearity_v2.log - the linearity re-check after
    the magnet was re-centred. It is a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
2026-09-21 docs(readme): lead with research framing, baseline, and lessons
    Reframe the README to read as a research project rather than a demo:
    - Lead with a one-line description and a 'Relation to prior work' section
    that positions against Marco et al. (2016) with a diff table (full LQG
    incl. (W,V), 11-D, reaction-wheel pendulum, from scratch) — the prior-work
    positioning was buried in docs/papers/; surface it up front. Fold the
    project goals + CMU 16-745 credit in, drop the informal prose and typos.
    - Embed the tuning-convergence figure (results/measured/convergence.png):
    best-so-far vs evaluation, with the blue scatter showing the cost noise.
    - Add the acquisition benchmark table (Entro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
2026-09-21 feat(scripts): measure cost-evaluation noise, and quantify it in the docs
    Add scripts/evaluation_noise.py: fix one controller (the tuned optimum
    from a run's metadata) and re-score it over N seeds, reporting the mean,
    spread, and coefficient of variation of the cost and headline metrics —
    the observation noise the GP surrogate models (optimization.md §1),
    measured directly rather than described qualitatively.
    On the measured build the cost has a ~20% CV (979 +/- 196 over 50
    seeds), almost all of it settling-time scatter (16% CV) while overshoot
    is stable (2.5%). Fold that hard number into the README's 'What we
    learned' noise bullet, list the script in the repo tree and the
    analysis-scrip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
    [evaluation_noise.py]
2026-09-21 feat(scripts): ARD relevance — which LQG weights the cost depends on
    Add scripts/ard_relevance.py: evaluate a space-filling design over the
    search box, fit the GP once with ML-II, and read the ARD lengthscales.
    A short lengthscale = the cost is sensitive to that weight; a long one =
    nearly flat. Relevance is box_width/lengthscale (dimensionless, since the
    inputs are raw log-weights with per-dimension box widths).
    Finding on the measured build (N=120 x 5 rollouts, sigma_n~41): the cost
    depends most on the LQR weights on the reaction-wheel states (Q.theta_w_dot,
    Q.theta_w) and on R, while the pendulum-angle weight comes out nearly
    irrelevant - the effective problem is lower-dimensional than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
    [ard_relevance.py]
2026-09-21 docs(papers): robustness on the identified (hardware-measured) plant
    The project's current headline finding lived only in a commit message:
    identifying the plant on hardware validated the model but flipped the
    control problem. Write it up as a proper analysis, the sequel to
    robustness_lqg_measured.md.
    - I_b validated to 1.0% (CAD confirmed); b_p measured 37x smaller than
    the guess (swing-up now feasible, 2.34s in sim); PLA wheel v2 lighter.
    - The measured pivot-encoder noise (2.63deg, non-white out-of-plane
    wobble) is the new binding constraint: re-tuning with the robustness
    term on still yields overshoot 218%, settling 9.99s, peak 17.4V past
    the rail, and a tuned-weight phase margi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
2026-09-21 docs: first-build photos and the pivot-sensor problem (current state)
    Add build/first_build/ with the build photos and a gallery README that
    makes the current hardware state explicit: the machine works and the
    identified parameters check out against CAD, but the pivot angle sensor
    is mounted with tape and a paper shim, so out-of-plane arm motion moves
    the theta_p reading by +/-4.6 deg at a fixed true angle (the 2.63 deg,
    non-white disturbance from sensor_characterisation.md). That noise is
    what drives the achievable phase margin negative (-21.2 deg) and blocks
    balancing - the fix is a rigid sensor mount, not more tuning.
    - build/first_build/README.md: wheel, motor/wheel-encoder, the pivot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
2026-09-21 docs(readme): move the build/current-state to the top, add a photo gallery
    Per review: the current state (the first build) now leads the README as
    its first section, with more photos. A centered hero shot of the complete
    build, then a 3-across detail row (reaction wheel, motor+wheel encoder,
    and the tape-and-shim pivot sensor flagged as the problem), then the
    one-paragraph explanation of why that loose pivot sensor -- not the plant
    -- drives the phase margin negative and blocks balancing. Uses inline
    HTML for a compact gallery that renders on GitHub.
2026-09-21 docs: soften sensor caption, note Onshape CAD, add next steps
    - Drop 'the problem' from the pivot-sensor image caption (the prose still
    explains why that channel is the blocker).
    - Note that the pendulum body was designed in CAD (Onshape), in both the
    README build section and the build gallery.
    - Add a 'Next steps' section (README) and mirror it in the gallery:
    1) redesign the pivot-sensor mount in CAD around the encoder's
    sensitivity (rigid, co-axial magnet) to kill the wobble at source;
    2) a stiffer body more resilient to vibration so it does not add sensor
    noise; 3) swing-up on hardware once the sensing is fixed.
